garthwebb/greenhouse/fold-away desk/braided-loop.png

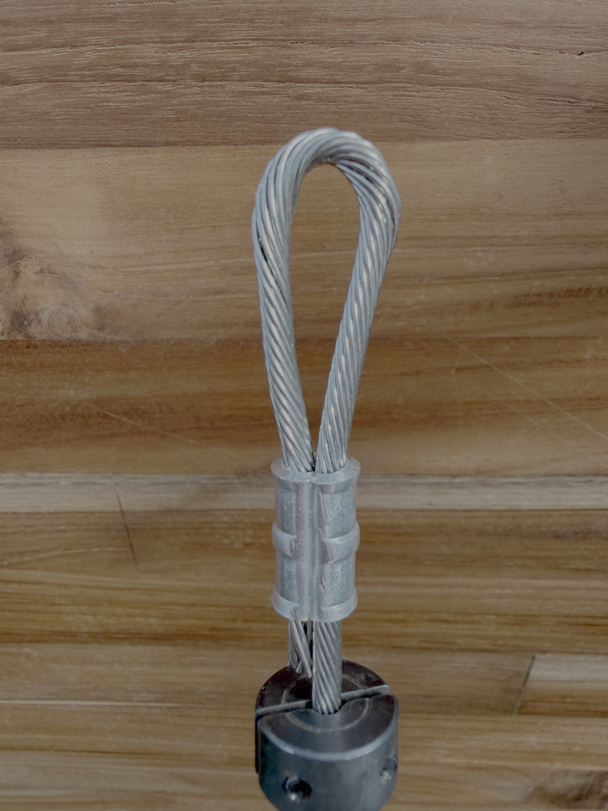
fold-away desk/braided-loop.png
