garthwebb/greenhouse/fold-away desk/bottom-mounrt.png

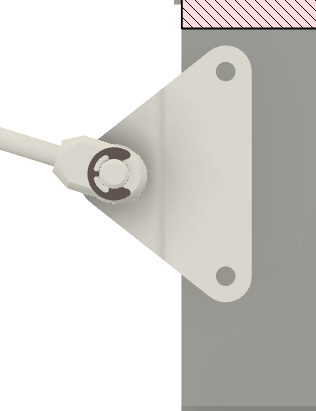
fold-away desk/bottom-mounrt.png
