garthwebb/greenhouse/fold-away desk/upper-brace.png

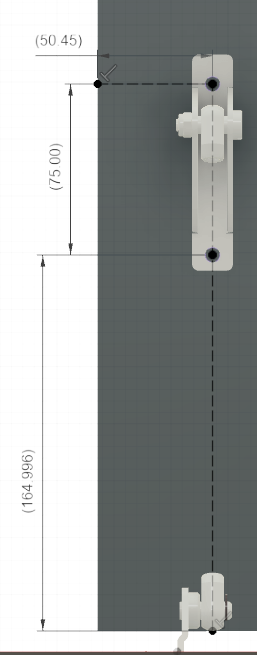
fold-away desk/upper-brace.png
