garthwebb/greenhouse/remote-sensors/enclosure/iso.png

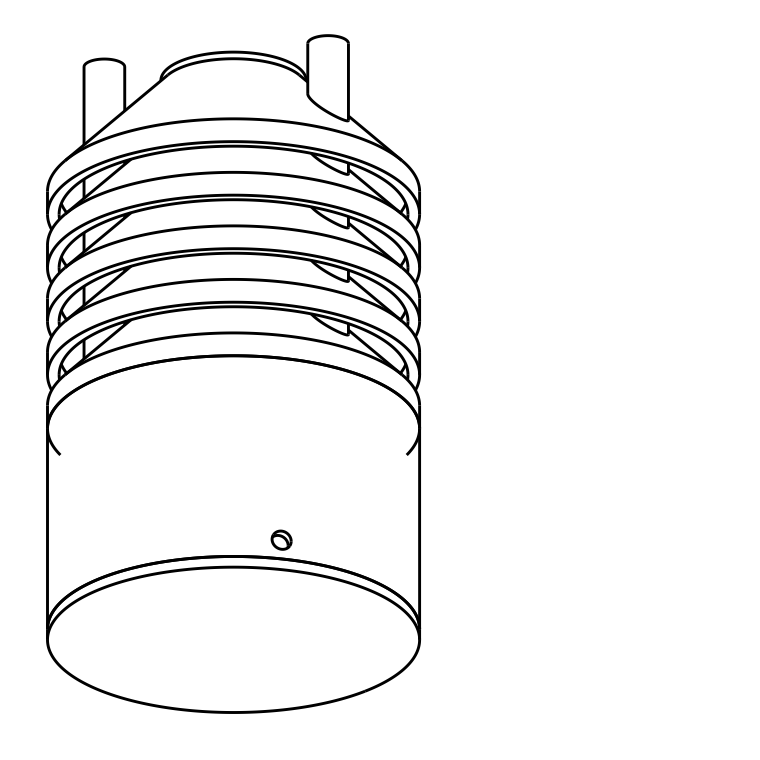
remote-sensors/enclosure/iso.png
