garthwebb/greenhouse/fold-away desk/m5-eye-and-side-bracket-A.stp

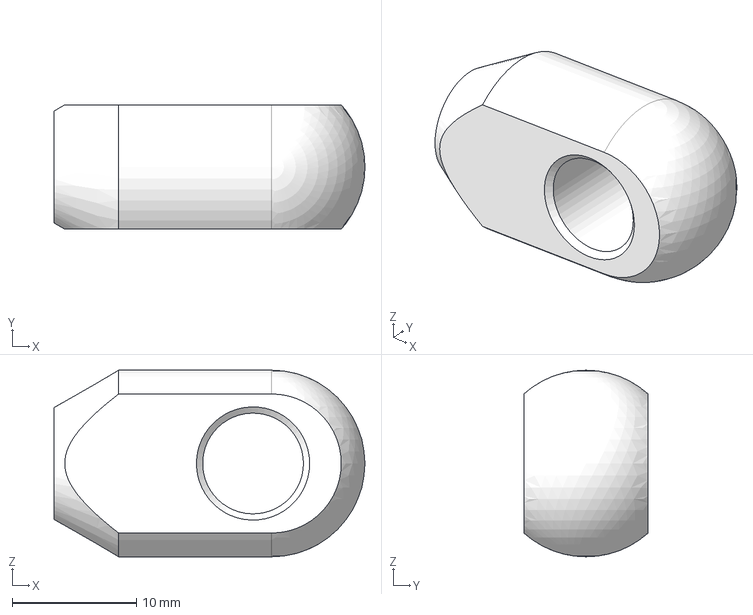
[picture p5: CAD file, 2026-10-09]
fold-away desk/m5-eye-and-side-bracket-A.stp
25.0 x 10.0 x 15.0 mm
