garthwebb/greenhouse/remote-sensors/enclosure/out/base.step

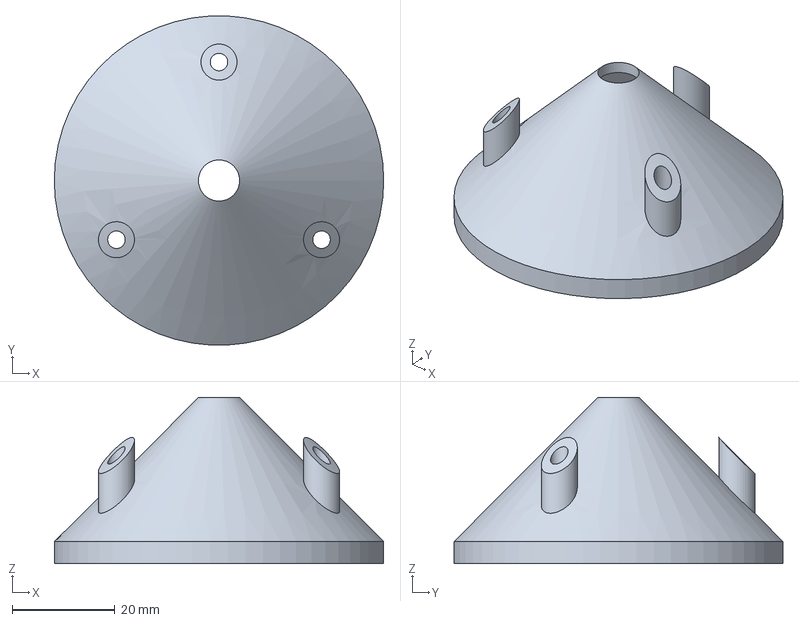
[picture p6: CAD file, 2026-10-16]
remote-sensors/enclosure/out/base.step
64.0 x 63.9 x 32.3 mm
