garthwebb/greenhouse/remote-sensors/enclosure/out/pod.stl

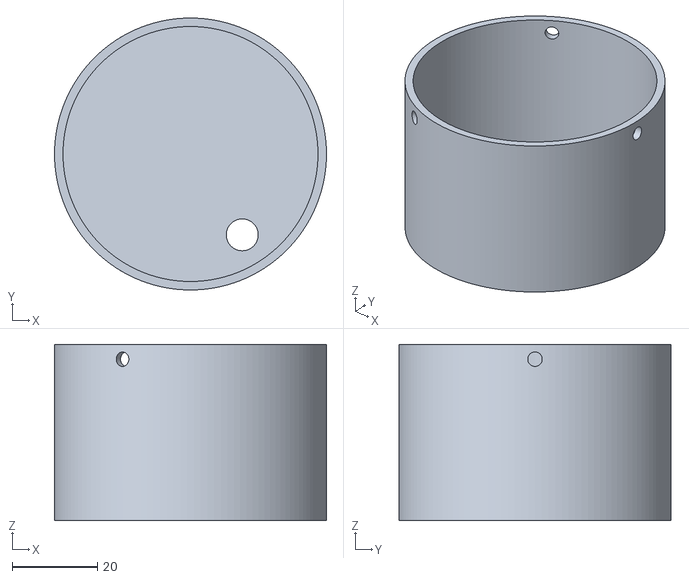
[picture p7: CAD file, 2026-10-16]
remote-sensors/enclosure/out/pod.stl
64.0 x 64.0 x 41.5
