garthwebb/greenhouse/remote-sensors/enclosure/out/grommet.step

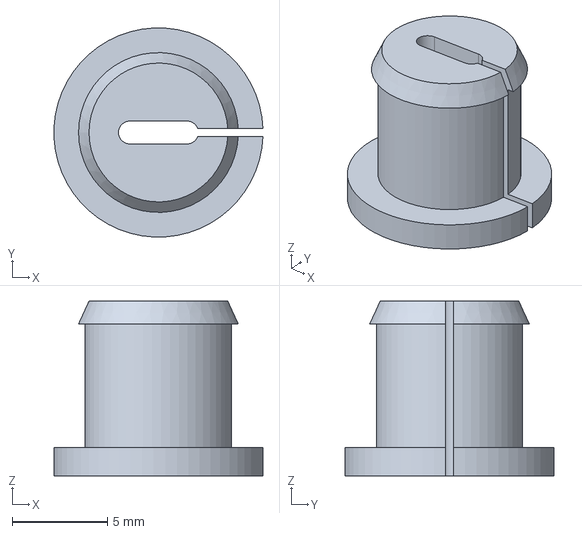
[picture p8: CAD file, 2026-10-16]
remote-sensors/enclosure/out/grommet.step
11.0 x 11.0 x 9.20 mm
