garthwebb/greenhouse/fold-away desk/m5-eye-and-bearing-shoe-B.stp

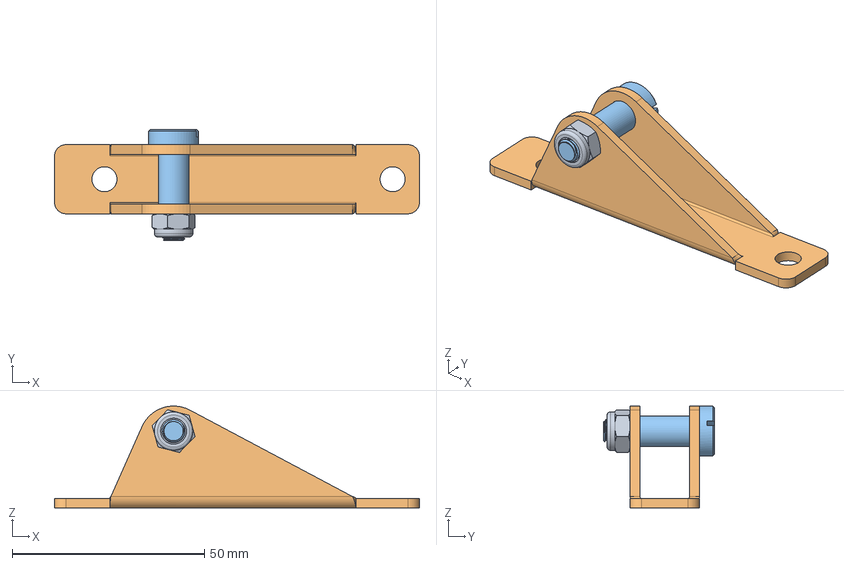
[picture p9: CAD file, 2026-10-09]
fold-away desk/m5-eye-and-bearing-shoe-B.stp
95.0 x 29.0 x 26.5 mm
