garthwebb/greenhouse/remote-sensors/enclosure/out/plate.step

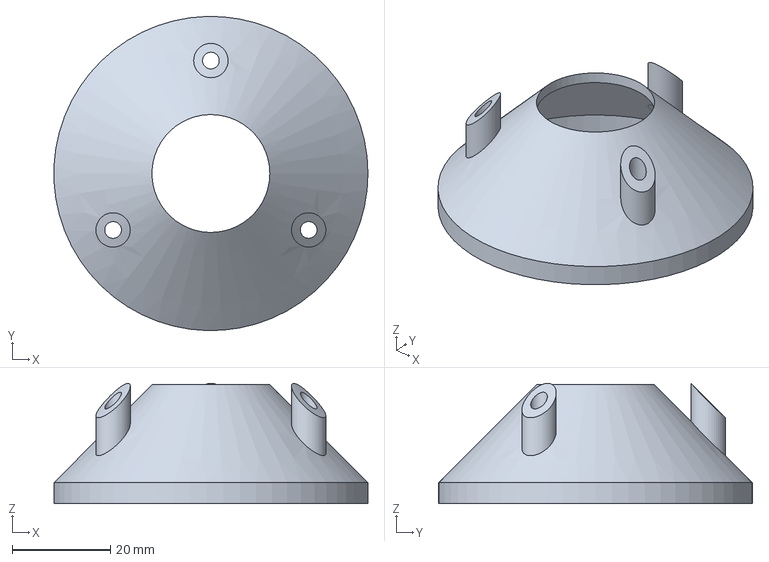
[picture p10: CAD file, 2026-10-16]
remote-sensors/enclosure/out/plate.step
64.0 x 64.0 x 24.5 mm
