garthwebb/greenhouse/remote-sensors/enclosure/out/pod_lid.stl

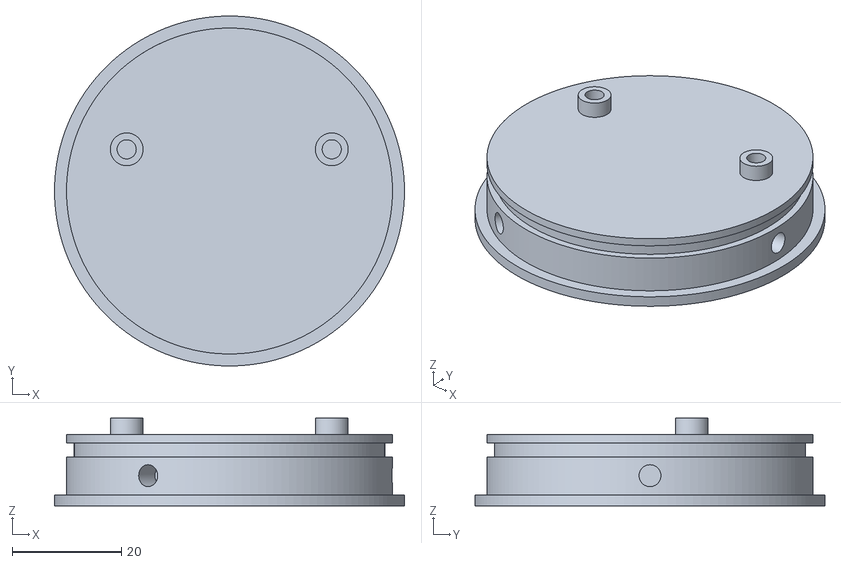
[picture p11: CAD file, 2026-10-16]
remote-sensors/enclosure/out/pod_lid.stl
64.0 x 64.0 x 16.0
