garthwebb/greenhouse/remote-sensors/enclosure/out/cap.step

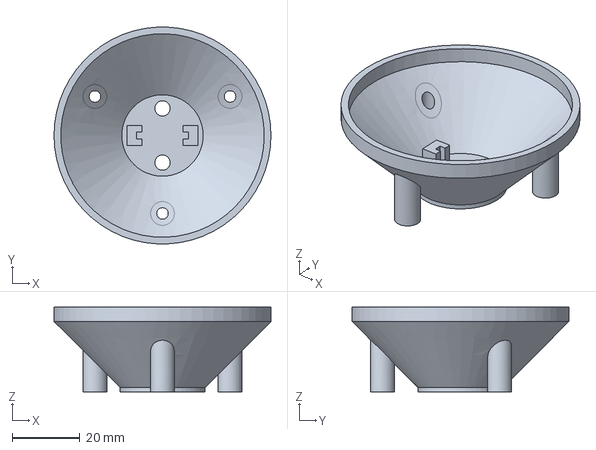
[picture p12: CAD file, 2026-10-16]
remote-sensors/enclosure/out/cap.step
64.0 x 63.9 x 25.0 mm
