garthwebb/greenhouse/(list of files, cad)

Other CAD files:
construction/Modular model.skp
construction/Single construction.skp
remote-sensors/enclosure/out/base.stl
