garthwebb/greenhouse/construction/Modular model.png

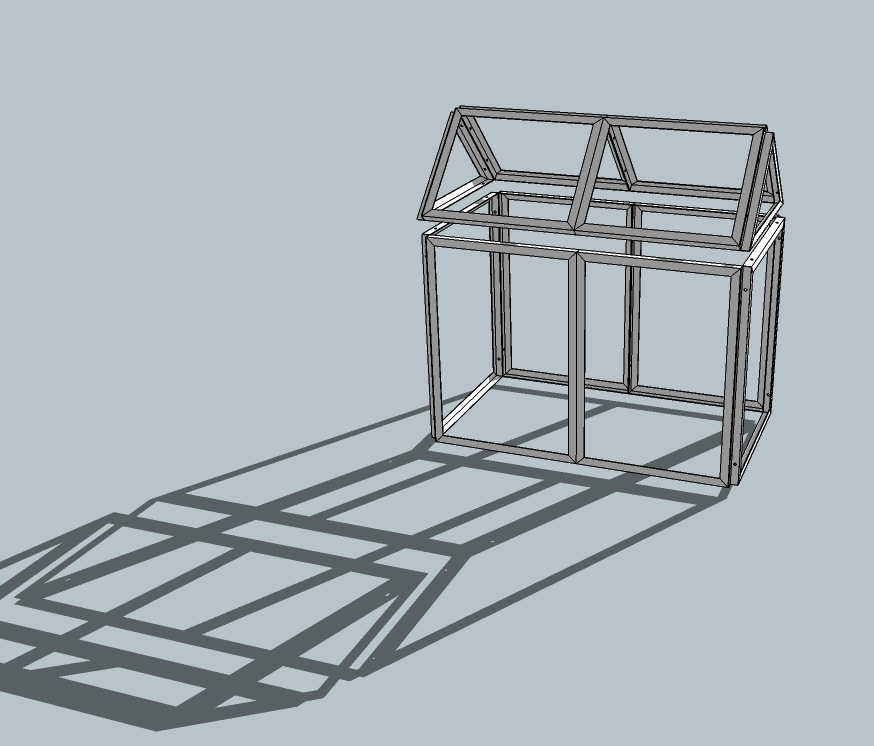
construction/Modular model.png
