garthwebb/greenhouse/remote-sensors/pcb/sensor-driver/sensor-driver/sensor-driver.kicad_pcb

## KiCad design remote-sensors/pcb/sensor-driver/sensor-driver/sensor-driver.kicad_pcb (2026-10-16)

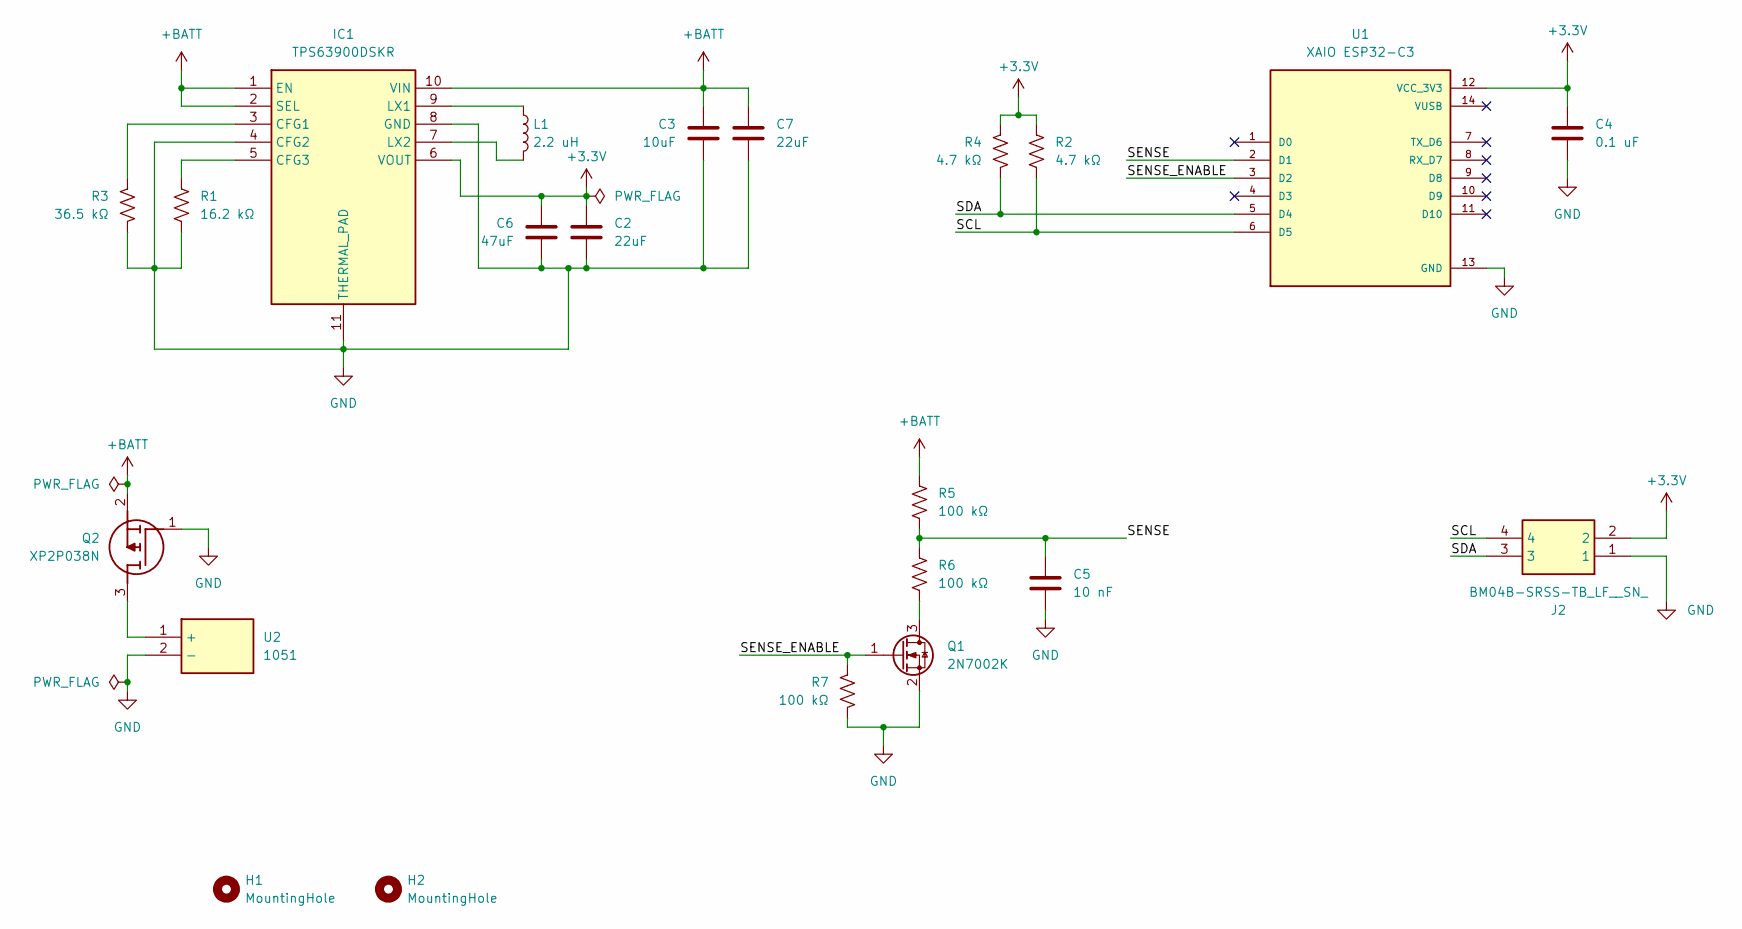
[picture p14: schematic sensor-driver.kicad_sch]

Parts:
C2, C7: 22uF; C_0805_2012Metric_Pad1.18x1.45mm_HandSolder
C3: 10uF; C_0805_2012Metric_Pad1.18x1.45mm_HandSolder
C4: 0.1 uF; C_0805_2012Metric_Pad1.18x1.45mm_HandSolder
C5: 10 nF; C_1206_3216Metric_Pad1.33x1.80mm_HandSolder
C6: 47uF; C_1206_3216Metric_Pad1.33x1.80mm_HandSolder
H1, H2: MountingHole; MountingHole_2.7mm_M2.5
IC1: TPS63900DSKR; SON50P250X250X80-11N-D; Mouser Part Number 595-TPS63900DSKR
J2: BM04B-SRSS-TB_LF__SN_; BM04B-SRSS-TB_LFSN_; Mouser Part Number N/A
L1: 2.2 uH; L_1008_2520Metric_Pad1.43x2.20mm_HandSolder
Q1: 2N7002K; SOT-23
Q2: XP2P038N; SOT95P230X109-3N; Manufacturer_Part_Number XP2P038N
R1: 16.2 kΩ; R_0805_2012Metric_Pad1.20x1.40mm_HandSolder
R2, R4: 4.7 kΩ; R_0805_2012Metric_Pad1.20x1.40mm_HandSolder
R3: 36.5 kΩ; R_0805_2012Metric_Pad1.20x1.40mm_HandSolder
R5, R6, R7: 100 kΩ; R_0805_2012Metric_Pad1.20x1.40mm_HandSolder
U1: XAIO ESP32-C3; MODULE_113991054; PARTREV 23/05/2022
U2: 1051; Mouser Part Number 534-1051

Connections:
+3.3V: C2.1, C4.1, C6.1, IC1.6 (VOUT), J2.2, R2.2, R4.2, U1.12 (VCC_3V3)
+BATT: C3.1, C7.1, IC1.1 (EN), IC1.2 (SEL), IC1.10 (VIN), Q2.2 (S), R5.2
/SCL: J2.4, R2.1, U1.6 (D5)
/SDA: J2.3, R4.1, U1.5 (D4)
/SENSE: C5.1, R5.1, R6.2, U1.2 (D1)
/SENSE_ENABLE: Q1.1 (G), R7.2, U1.3 (D2)
GND: C2.2, C3.2, C4.2, C5.2, C6.2, C7.2, IC1.4 (CFG2), IC1.8 (GND), IC1.11 (THERMAL_PAD), J2.1, Q1.2 (S), Q2.1 (G), R1.1, R3.1, R7.1, U1.13 (GND), U2.2 (-)
unnamed: IC1.3 (CFG1), R3.2
unnamed: IC1.5 (CFG3), R1.2
unnamed: IC1.9 (LX1), L1.1
unnamed: IC1.7 (LX2), L1.2
unnamed: Q1.3 (D), R6.1
unnamed: Q2.3 (D), U2.1 (+)

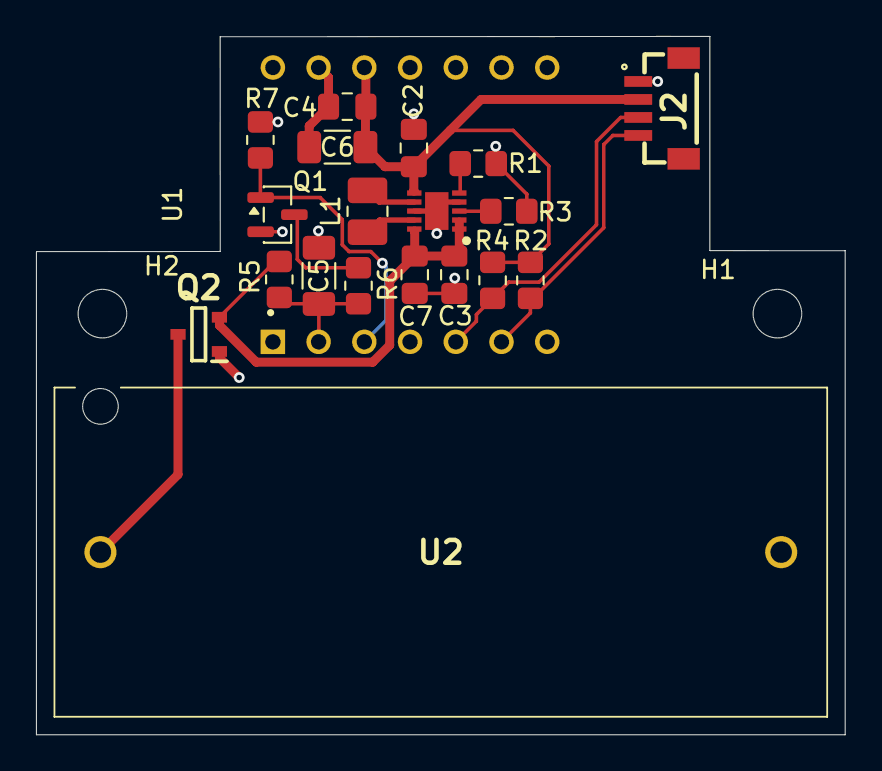
[picture p15: board sensor-driver.kicad_pcb from above]

Board: 2 copper layers, 44.9 x 38.8 mm, 22 parts (0 on the bottom side), 13 nets.
