garthwebb/greenhouse/controller/pcb/Greenhouse Board.kicad_pcb

## KiCad design controller/pcb/Greenhouse Board.kicad_pcb (2025-06-21)

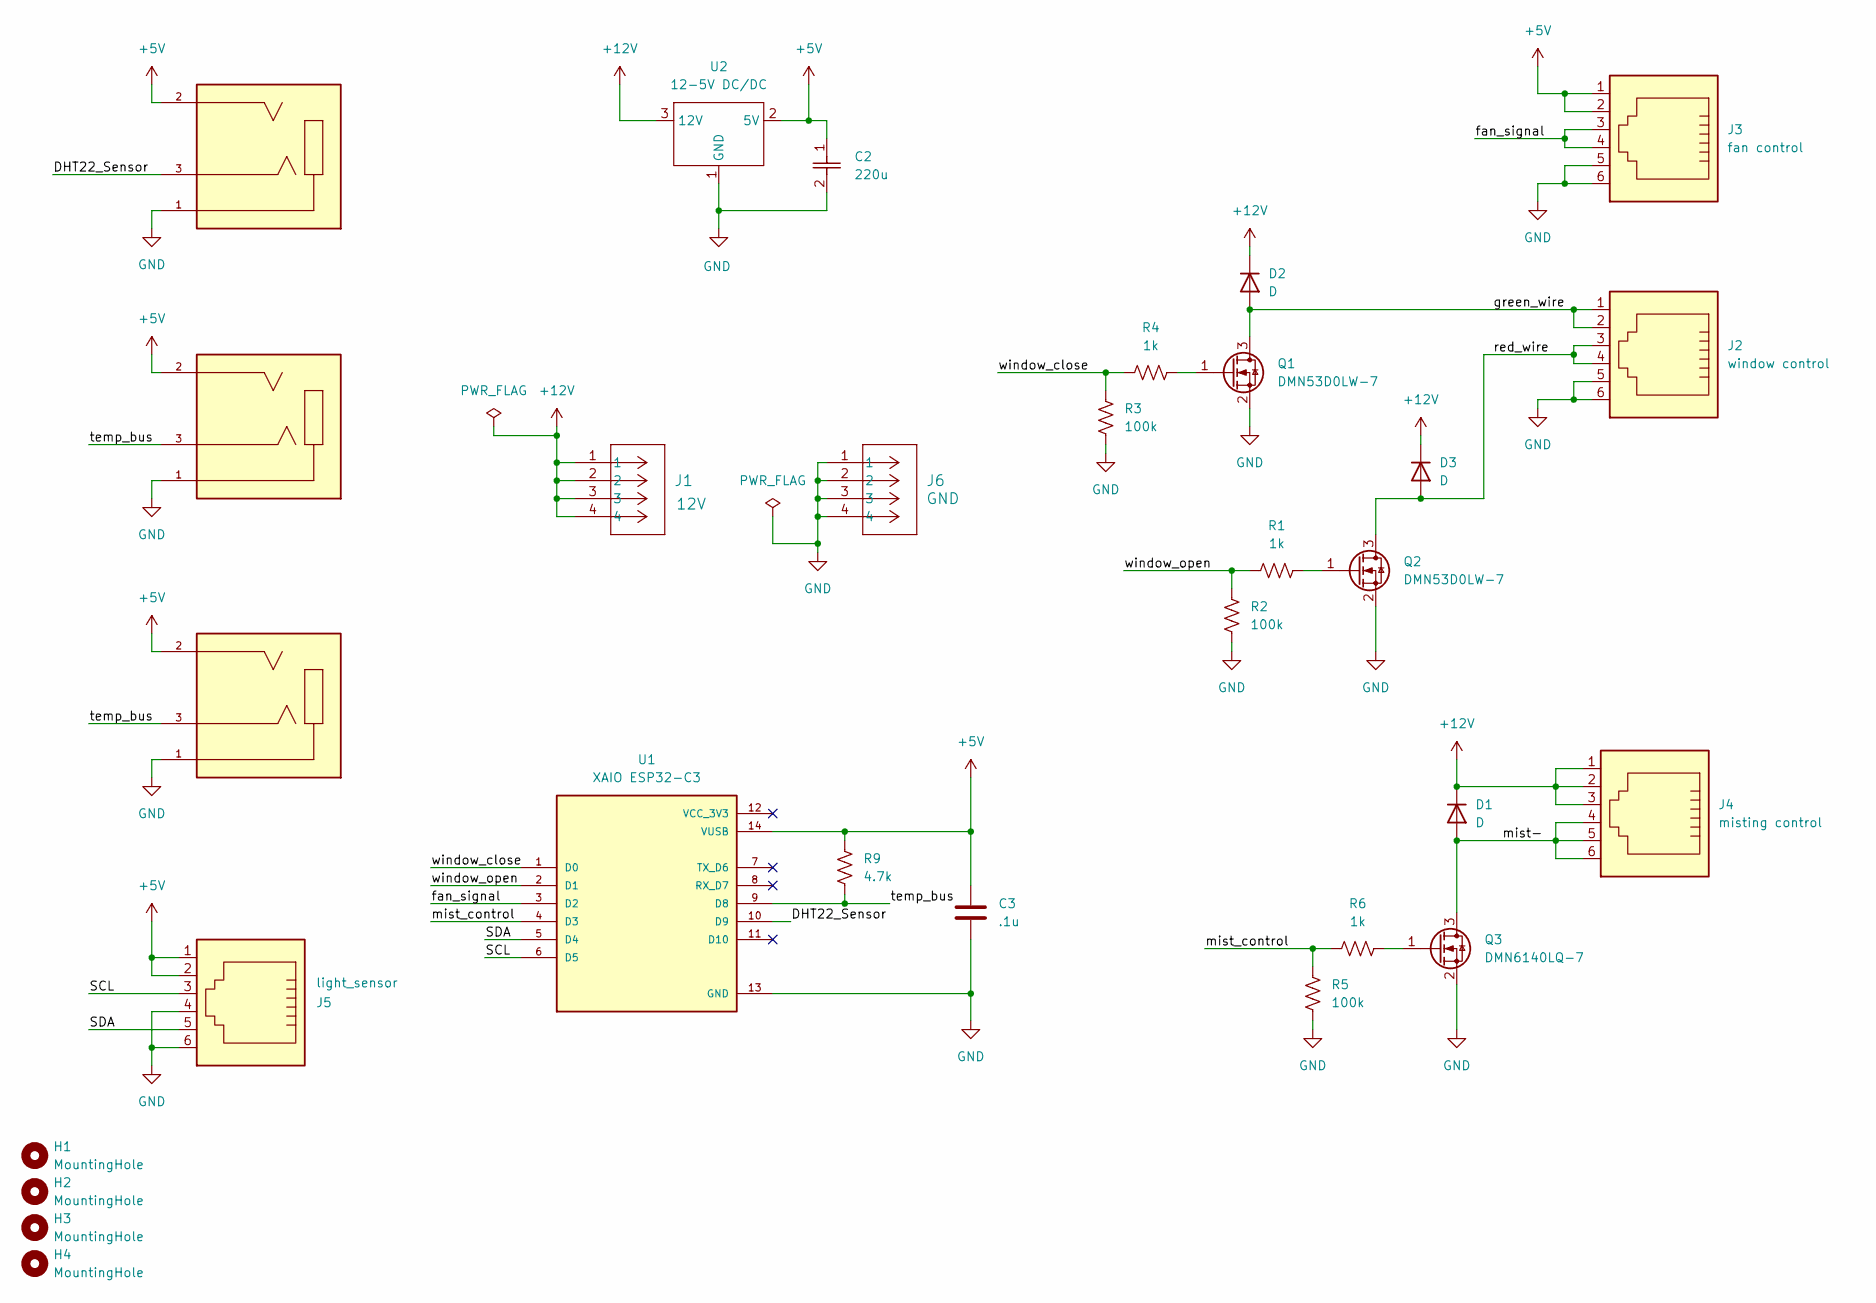
[picture p16: schematic Greenhouse Board.kicad_sch]

Parts:
C2: 220u; CAP_SP-CAP_SR_PAN
C3: .1u; C_0805_2012Metric
D1, D2, D3: D; SOD323_DIO
H1, H2, H3, H4: MountingHole; MountingHole_3.2mm_M3
J1: 12V; screw-terminal-CONN4_TB002-500_787x299_CUD
J2: window control; RJ11-RA; PARTREV N
J3: fan control; RJ11-RA; PARTREV N
J4: misting control; RJ11-RA; PARTREV N
J5: light_sensor; RJ11-RA; PARTREV N
J6: GND; screw-terminal-CONN4_TB002-500_787x299_CUD
J7: T+H sensor; 1_8jack-CUI_SJ2-35853A-SMT-TR; PARTREV 1.04
J8: temp sensor 1; 1_8jack-CUI_SJ2-35853A-SMT-TR; PARTREV 1.04
J9: temp sensor 2; 1_8jack-CUI_SJ2-35853A-SMT-TR; PARTREV 1.04
Q1, Q2: DMN53D0LW-7; SOT-323_SC-70_Handsoldering
Q3: DMN6140LQ-7; SOT-323_SC-70_Handsoldering
R1, R4, R6: 1k; R_0805_2012Metric_Pad1.20x1.40mm_HandSolder
R2, R3, R5: 100k; R_0805_2012Metric_Pad1.20x1.40mm_HandSolder
R9: 4.7k; R_0805_2012Metric_Pad1.20x1.40mm_HandSolder
U1: XAIO ESP32-C3; MODULE_113991054; PARTREV 23/05/2022
U2: 12-5V DC/DC; Power Module 6-pin

Connections:
+5V: C2.1, C3.1, J3.1, J3.2, J5.1, J5.2, J7.2, J8.2, J9.2, R9.1, U1.14 (VUSB), U2.2 (5V)
+12V: D1.1 (K), D2.1 (K), D3.1 (K), J1.1, J1.2, J1.3, J1.4, J4.1, J4.2, J4.3, U2.3 (12V)
/DHT22_Sensor: J7.3, U1.10 (D9)
/SCL: J5.3, U1.6 (D5)
/SDA: J5.5, U1.5 (D4)
/fan_signal: J3.3, J3.4, U1.3 (D2)
/green_wire: D2.2 (A), J2.1, J2.2, Q1.3 (D)
/mist-: D1.2 (A), J4.4, J4.5, J4.6, Q3.3 (D)
/mist_control: R5.1, R6.1, U1.4 (D3)
/red_wire: D3.2 (A), J2.3, J2.4, Q2.3 (D)
/temp_bus: J8.3, J9.3, R9.2, U1.9 (D8)
/window_close: R3.1, R4.1, U1.1 (D0)
/window_open: R1.1, R2.1, U1.2 (D1)
GND: C2.2, C3.2, J2.5, J2.6, J3.5, J3.6, J5.4, J5.6, J6.1, J6.2, J6.3, J6.4, J7.1, J8.1, J9.1, Q1.2 (S), Q2.2 (S), Q3.2 (S), R2.2, R3.2, R5.2, U1.13 (GND), U2.1 (GND)
unnamed: Q1.1 (G), R4.2
unnamed: Q2.1 (G), R1.2
unnamed: Q3.1 (G), R6.2

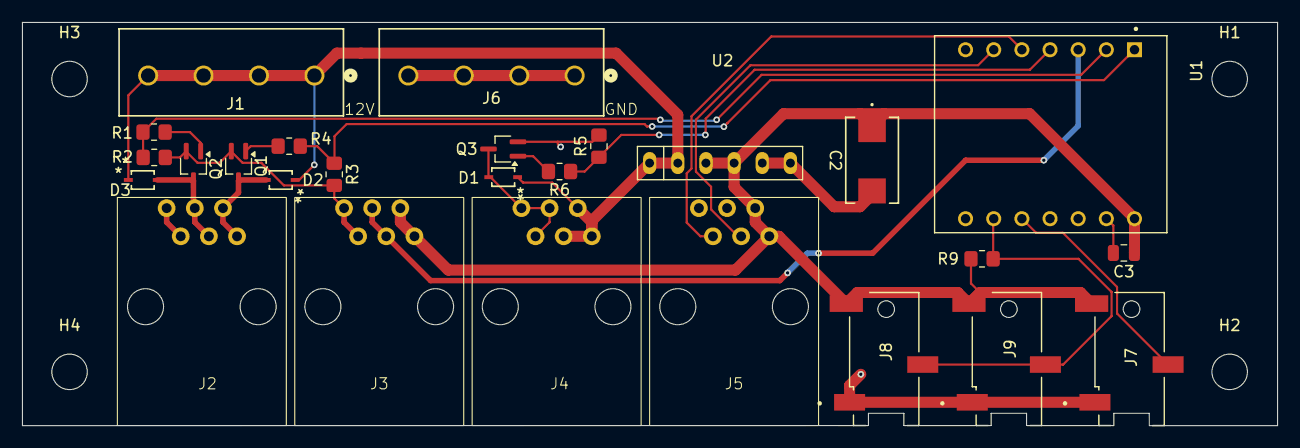
[picture p17: board Greenhouse Board.kicad_pcb from above]

Board: 2 copper layers, 113.2 x 36.4 mm, 30 parts (0 on the bottom side), 17 nets.
