garthwebb/greenhouse/remote-sensors/pcb/sensor-board/sensor-board.kicad_sch

## KiCad design remote-sensors/pcb/sensor-board/sensor-board.kicad_sch (2026-10-16)

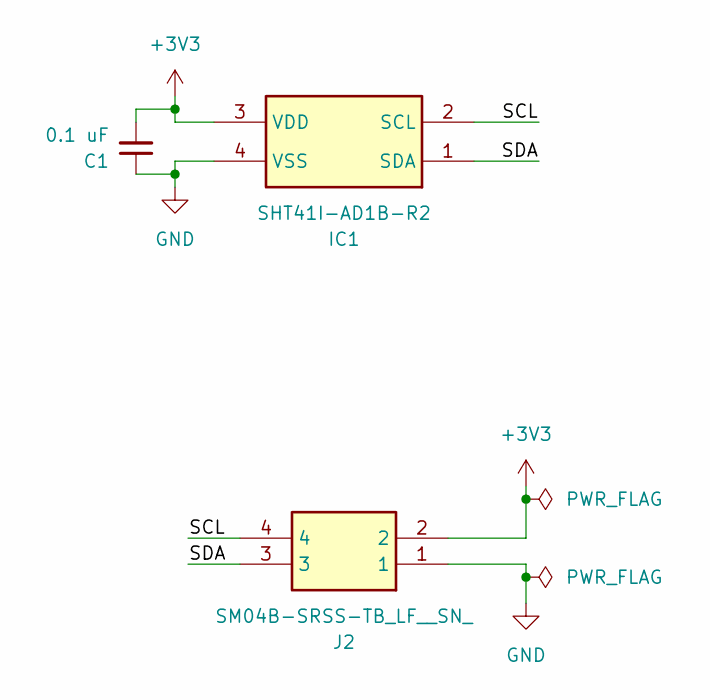
[picture p18: schematic sensor-board.kicad_sch]

Parts:
C1: 0.1 uF; C_0805_2012Metric_Pad1.18x1.45mm_HandSolder
IC1: SHT41I-AD1B-R2; Sensirion_DFN-4_1.5x1.5mm_P0.8mm_SHT4x_NoCentralPad; Mouser Part Number 403-SHT41I-AD1B-R2
J2: SM04B-SRSS-TB_LF__SN_; SM04B-SRSS-TB_LFSN_; Mouser Part Number 306-SM04BSRSSTBLFSN

Connections:
+3V3: C1.2, IC1.3 (VDD), J2.2
GND: C1.1, IC1.4 (VSS), J2.1
SCL: IC1.2 (SCL), J2.4
SDA: IC1.1 (SDA), J2.3
