garthwebb/greenhouse/(commit log)

2024-06-07 Update to move Adruido project to VSCode project, plus clean up
    * moved some components to libraries
    * improved async process handling like window opening
    [Greenhouse Board.kicad_pcb, Greenhouse Board.kicad_sch, Modular model.skp, Single construction.skp]
2025-04-02 Checkpoint changes before updating design
    [Greenhouse Board.kicad_pcb]
2025-04-07 Create a watchdog timer, as well as set a hostname for this device.
2025-04-10 Introduce 1/8" jack components and add additional inputs and outputs
    [Greenhouse Board.kicad_sch]
2025-04-11 Move the watchdog timer to after all the setup and shorten its TTL. Also introduce an Telemetry class, but keep it commented out for the moment.
    [monitor.cpp, monitor.h]
2025-04-12 Only have one thing that represents the name of this device on the network.
2025-06-21 Added libraries to monitor a different type of temperature sensor, a light sensor, and toggle a misting system. This new functionality is tested within the test-new-pcb file and platformio.ini profil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
2025-06-21 Updates to the PCB to expand its inputs/outputs
    [Greenhouse Board-B_Cu.gbr, Greenhouse Board-B_Mask.gbr, Greenhouse Board-B_Paste.gbr, Greenhouse Board-B_Silkscreen.gbr, Greenhouse Board-Edge_Cuts.gbr, Greenhouse Board-F_Cu.gbr, Greenhouse Board-F_Mask.gbr, Greenhouse Board-F_Paste.gbr]
2025-07-12 Added logging, and error checking for the HTTP connection. Also addressed some memory leaks with the _doc object reuse. Also resetting the HTTP connection on every monitor (happens once a minute) so 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
2025-07-12 Handle not finding the light sensor. Mainly to allow the code to keep running while we're testing and don't have everything connected.
2025-07-12 Also log missing light sensors to syslog
2025-07-12 Reuse the last readings from this sensor if a reading can't be made instead of returning zero. Zero gets logged and it looks like the values jump around on the graph when really there's no data.
2025-07-12 Moved control and decision making to the ClimateControl object. Also bundle controls into a ControlObjects object and sensors into a SensorObjects object.
2025-07-12 Fold the experiment settings into a production config, but keeping a teting host and device name while we do integration testing.
2025-07-15 An extra "-1" in an array index was causing kernel panics as the value it was subtracting from could be zero, and thus try to access index -1. This was causing the esp32 to reboot every 60 minutes as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
    Also did some standarization of names, and updated a logging method.
    [monitor.cpp]
2025-08-07 Committing changes to TempHumidity sensor before completely swapping out the code to instead run with the AHT20
2025-08-25 Updated the Temp/Humidity sensor to an i2c version that does not suffer from the timing/interrupt issues that the other did. This fixed things, so installed the new controller, updated it's name to n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
2025-08-25 Helper function added to track whether the temp is currently rising or falling. The controller was opening windows because it anticipated it would reach the limit soon, but then immediately closed be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
2025-08-25 Make the light sensor less sensitive since it will get bright in the greenhouse
2026-10-09 Commit most recent schematic changes
    [Greenhouse Board.kicad_sch]
2026-10-09 Files related to the construction of the fold away greeenhouse desk/workspace
    [gas-spring-6-15-stroke-120.stp, m5-eye-and-bearing-shoe-A.stp, m5-eye-and-bearing-shoe-B.stp, m5-eye-and-side-bracket-A.stp, m5-eye-and-side-bracket-B.stp]
2026-10-09 Add min dwell for window/fan and a high-humidity vent rule
    The window open rule uses the long temp delta and the close rule uses the
    short delta. With the temp near target, a long-term rise and a short-term
    dip make both true, so the window reversed every 5s monitor cycle (seen
    2026-09-21 and 09-25). The fan rules have the same asymmetry. Temperature
    rules now can't reverse either one until it has held its state for
    min_dwell_s (default 10 min).
    Nothing acted on high humidity, which sits at 75-84% overnight. When
    humidity stays above humidity_vent_max (80%) for humidity_vent_trigger_s
    (20 min) and the temp is above min_temp_f, open the window and run the
    fan for humidity_vent_on_s (10 min),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
2026-10-15 Subscribe to remote sensor readings over MQTT
    RemoteSensors keeps the latest reading from each battery sensor published to
    greenhouse/sensors/+/state, flags stale readings and low batteries, and the
    new 'remote' WebSerial command lists them. Readings aren't used for climate
    control yet.
2026-10-15 Add battery-powered remote temp/humidity sensors
    - sensor-node: deep-sleeps, reads an SHT4x, sends one ESP-NOW packet with the
    battery voltage under load and a running charge estimate
    - gateway-radio: ESP-NOW receiver on a fixed channel, forwards over UART
    - gateway-uplink: WiFi client that publishes each reading to MQTT
    - tiger-pi: Mosquitto and Telegraf configs to land readings in InfluxDB
2026-10-15 Add remote sensor boards, housing and datasheets
    - sensor-board: SHT41I on a 15x10 mm board with a Qwiic connector
    - sensor-driver: XIAO ESP32-C3, CR123A with reverse protection, TPS63900
    buck-boost and a switched battery divider
    - enclosure: radiation shield on a sealed pod, generated by sensor_housing.py,
    which reads the driver board's layout to check fit
    - Ignore KiCad local history folders
2026-10-15 Rearrange sensor board pin labels on the silkscreen
